RowanP4069/Arduino_Due_6-channel_Servo_Current_Sensor_Shield/README.md

# Arduino_Due_6-channel_Servo_Current_Sensor_Shield

Project information - https://www.hackster.io/rpatterson/arduino-due-6-channel-servo-current-sensor-shield-6fad15
