RowanP4069/Arduino_Due_6-channel_Servo_Current_Sensor_Shield/Arduino Sketch Examples/README.md

# Example Sketches:
- Sample_1.ino : Minimal example, read one sensor
- Sample_2.ino : Add smoothing
- Sample_3.ino : Add multiple sensors
- Sample_4.ino : Add non-blocking
