RowanP4069/Arduino_Due_6-channel_Servo_Current_Sensor_Shield/Arduino Sketch Examples/Sample_4 output example.png

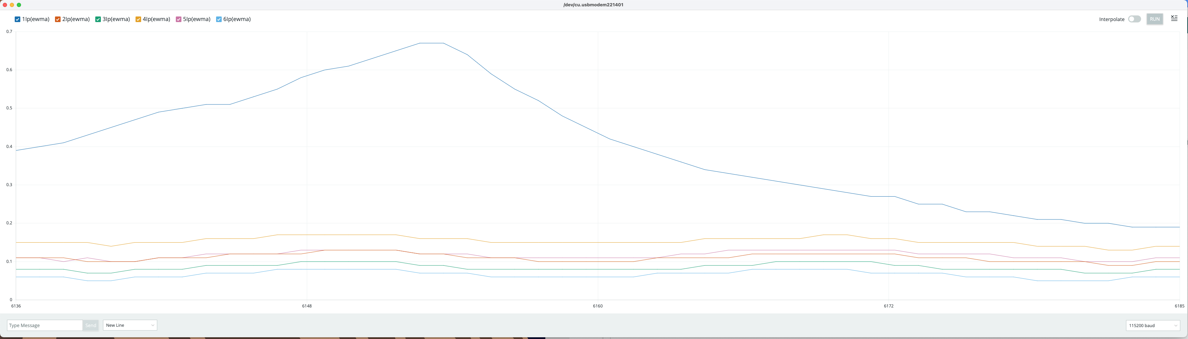
Arduino Sketch Examples/Sample_4 output example.png
