RowanP4069/Arduino_Due_6-channel_Servo_Current_Sensor_Shield/PCB.png

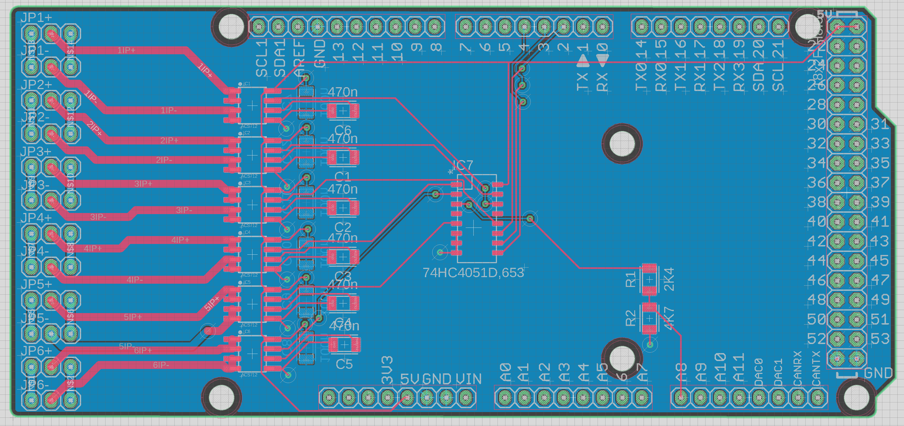
PCB.png
