RowanP4069/Arduino_Due_6-channel_Servo_Current_Sensor_Shield/Schematic.png

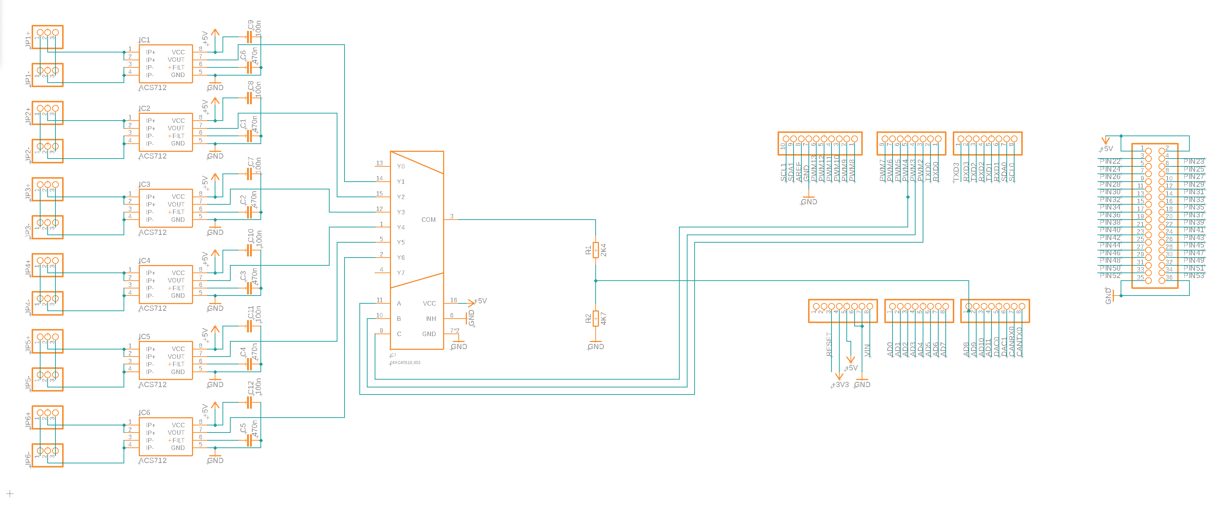
Schematic.png
